YaMaisiukDranko/ndtp-drone-autopilot/Проект/Презентация Мойсюк-Дранько.pptx

## Канал управления БПЛА с применением технологии ППРЧ

Выполнил:
Мойсюк-Дранько Ярослав Алексеевич,
учащийся
УО «Национальный детский технопарк»
