YaMaisiukDranko/ndtp-drone-autopilot/3D/ndtp-rc-boxer v14 bottom.stl

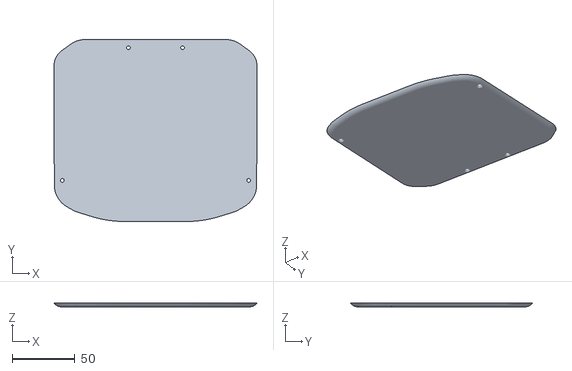
[picture p13: CAD file, 2025-10-20]
3D/ndtp-rc-boxer v14 bottom.stl
161.3 x 144.6 x 3.00
