YaMaisiukDranko/ndtp-drone-autopilot/3D/ndtp-rc-boxer v14 top.stl

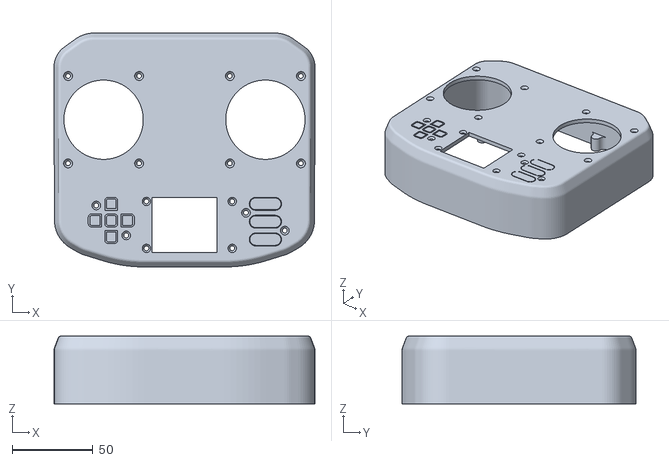
[picture p14: CAD file, 2025-10-20]
3D/ndtp-rc-boxer v14 top.stl
161.3 x 144.6 x 42.0
