YaMaisiukDranko/ndtp-drone-autopilot/Code/data_sender_nrf/data_sender_nrf.ino

/*
Победа над nRF24L01: на три шага ближе, передатчик
https://habr.com/ru/post/476716/
*/

#include <SPI.h>
#include <RF24.h>
#define CE_PIN    4   // Можно использовать любой GPIO
#define CSN_PIN   5
#define MOSI_PIN   15
#define MISO_PIN   12
#define SCK_PIN   18 
RF24 radio(4, 5); // порты D9, D10: CSN CE
const uint32_t pipeAddress = 111156789; // адрес рабочей трубы;

byte data;

void setup() {
  Serial.begin(115200);
  SPI.begin(SCK_PIN, MISO_PIN, MOSI_PIN, CSN_PIN);
  Serial.println("TransmitterTester ON");

  radio.begin();                // инициализация
  delay(2000);
  radio.setDataRate(RF24_1MBPS); // скорость обмена данными RF24_1MBPS или RF24_2MBPS
  radio.setCRCLength(RF24_CRC_8); // размер контрольной суммы 8 bit или 16 bit
  radio.setPALevel(RF24_PA_MAX); // уровень питания усилителя RF24_PA_MIN, RF24_PA_LOW, RF24_PA_HIGH and RF24_PA_MAX
  radio.setChannel(0x6f);         // установка канала
  radio.setAutoAck(false);       // автоответ
  radio.powerUp();               // включение или пониженное потребление powerDown - powerUp
  radio.stopListening();  //радиоэфир не слушаем, только передача
  radio.openWritingPipe(pipeAddress);   // открыть трубу на отправку
}

void loop() {
  data = 109;
  radio.write(&data, 1);
  Serial.println("data= " + String(data));
}
