YaMaisiukDranko/ndtp-drone-autopilot/Code/getSPI/getSPI.ino

//Find the default SPI pins for your board          
//Make sure you have the right board selected in Tools > Boards
void setup() {
  // put your setup code here, to run once:
  Serial.begin(115200);
  Serial.print("MOSI: ");
  Serial.println(MOSI);
  Serial.print("MISO: ");
  Serial.println(MISO);
  Serial.print("SCK: ");
  Serial.println(SCK);
  Serial.print("SS: ");
  Serial.println(SS);  
  Serial.println(SCL);
  Serial.println(SDA);
}

void loop() {
  // put your main code here, to run repeatedly:
}
