YaMaisiukDranko/ndtp-drone-autopilot/(commit log)

2025-10-04 FHSS template
    [drone_esp32_xiao.kicad_pcb, drone_esp32_xiao.kicad_sch]
2025-10-13 Some changes in telemetry
    [ndtp-rc-boxer v14 bottom.stl, ndtp-rc-boxer v14 top.stl]
2025-10-20 Bug fixed, FHSS works!
    [fhss_RX.ino, fhss_TX.ino]
2025-10-21 Throttle works! Flight!
2025-10-21 Create stabilization and PID
